HexabitzPlatform/H07R8x/README.md

# H07R8x-Hardware
Hexabitz 10W Stereo Audio Amplifier Module Hardware Design
