HexabitzPlatform/H07R8x/Rleased/BOM/H07R8.xlsx

 |  | www.hexabitz.com info@hexabitz.com |  | Bill Of Materials
Customer | Hexabitz | Revision | 0
Project | Hexabitz Modules | Date | 2024-02-20
Board | 10W Stereo Audio Amplifier (H07R8) | Notes
Designator | Description | Manufacturer Part Number | Manufacturer | Octopart Url | Quantity
R | Headers & Wire Housings Unshrouded 1 POS T/H | 5-146280-1 | TE Connectivity | https://octopart.com/5-146280-1-te+connectivity+%2F+amp-40259676?r=sp | 1
SWD | Conn Unshrouded Header HDR 3 POS 2.54mm Solder ST Top Entry Thru-Hole Carton | 5-146281-3 | TE Connectivity | https://octopart.com/5-146281-3-te+connectivity+%2F+amp-39745942?r=sp | 1
J1, J2, J3 | TERM BLK 2POS SIDE ENT 3.5MM PCB | 1751248 | Phoenix Contact | https://octopart.com/1751248-phoenix+contact-31334?r=sp | 3
J4 | CONN JACK STEREO 3.5MM SMD R/A | SJ-3524-SMT-TR | CUI Devices | https://octopart.com/sj-3524-smt-tr-cui+devices-106234236?r=sp | 1
R1, FB3, FB4, FB5, FB6 | RES SMD 0.0OHM JUMPER 1/10W 0603 | RC0603JR-070RL | YAGEO [VR] | https://octopart.com/rc0603jr-070rl-yageo-1241539?r=sp | 5
R5, R10, R11, R12, R13, R14 | RES 100 OHM 1% 1/10W 0603 | RMCF0603FT100R | YAGEO | https://octopart.com/rmcf0603ft100r-stackpole+electronics-19212927?r=sp | 6
R2 | Thick Film Resistors - SMD 0603 270 Ohm 5% Tol | ERJ-3GEYJ271V | Panasonic | https://octopart.com/erj-3geyj271v-panasonic-55560546?r=sp | 1
R7, R8 | RES 4.7K OHM 1% 1/10W 0603 | RMCF0603FT4K70 | Stackpole Electronics Inc | https://octopart.com/rmcf0603ft4k70-stackpole+electronics-19213269?r=sp | 2
R3, R6, R9 | RES 10K Ohm 1% 0603 | RC0603FR-0710KL | Yageo | https://octopart.com/rc0603fr-0710kl-yageo-40025538?r=sp | 3
R4 | RES 100K OHM 1% 1/10W 0603 | RC0603FR-10100KL | YAGEO | https://octopart.com/rc0603fr-10100kl-yageo-12819539?r=sp | 1
C32, C38, C42, C43 | CAP CER 100PF 50V X7R 0603 | CC0603KPX7R9BB101 | YAGEO | https://octopart.com/cc0603kpx7r9bb101-yageo-25628258?r=sp | 4
C21 | CAP CER 10000PF 50V X7R 0603 | CC0603KRX7R9BB103 | YAGEO | https://octopart.com/cc0603krx7r9bb103-yageo-192938?r=sp | 1
C1, C2, C4, C6, C45 , C8, C9, C13 | CAP CER 0.1UF 25V X7R 0603 | CGA3E2X8R1E104K080AE | TDK | https://octopart.com/cga3e2x8r1e104k080ae-tdk-68305753?r=sp | 8
C10, C11, C18, C19, C20, C22, C23, C24, C25, C27, C28, C39, C40 | CAP CER 0.47UF 25V X5R 0603 | C1608X5R1E474K080AC | TDK Corporation | https://octopart.com/c1608x5r1e474k080ac-tdk-25947645?r=sp | 13
C5 | CAP CER 1 UF 16V X7R 0805 | CC0805KKX7R7BB105 | YAGEO [VA] | https://octopart.com/cc0805kkx7r7bb105-yageo-8376555?r=sp | 1
C15, C16, C17, C33, C34, C35, C36, C37, C44 | CAP CER 1UF 10V X5R 0603 | GRM188R61A105KA61J | MURATA ELECTRON ICS | https://octopart.com/grm188r61a105ka61j-murata-9221870?r=sp | 9
C12 | CAP CER 1UF 50V X5R 0603 | UMK107BJ105KA-T | Taiyo Yuden | https://octopart.com/umk107bj105ka-t-taiyo+yuden-12090744?r=sp | 1
C14 | CAP CER 2.2UF 16V X5R 0603 | CL10A225KO8NNNC | Samsung Electro-Mechanics | https://octopart.com/cl10a225ko8nnnc-samsung-19018971?r=sp | 1
C3 , C7 | CAP CER 4.7UF 16V X7R 0805 | C0805C475K4RACTU | KEMET [VA] | https://octopart.com/c0805c475k4ractu-kemet-22859922?r=sp | 2
C30, C31 | CAP ALUM HYB 47UF 20% 50V SMD | A780EN476M1HLAS050 | KEMET | https://octopart.com/a780en476m1hlas050-kemet-133897287?r=sp | 2
FB1 | Ind chip Bead Multi-Layer 30 ohms 25% 100MHZ Ferrite 1,5A 0603Punched paper T/R | MMZ1608Y300BTA00 | TDK | https://octopart.com/mmz1608y300bta00-tdk-7906990?r=sp | 1
Q2 | MOSFET N-CH 30V 5.7A SOT23-3L | AO3400A | Alpha & Omega Semiconductor Inc. | https://octopart.com/ao3400a-alpha+%26+omega+semiconductor-10533924?r=spc#CadModels | 1
D1 | Red 0603 130° Clear 54 mcd 2 V Surface Mount ChipLED | VLMS1300-GS08 | Vishay | https://octopart.com/vlms1300-gs08-vishay-21709201?r=sp | 1
D2 | TVS DIODE 3,3V 10,9V SOD323 | CDSOD323-T03SC | BOURNS INC | https://octopart.com/cdsod323-t03sc-bourns-10487153?r=sp | 1
U1 | MCU 32-Bit ARM Cortex-M0+ RISC 512kByte Flash 1.7V to 3.6V 48-Pin UFQFPN Tray | STM32G0B1CEU6N | STMicroelectronics | https://octopart.com/stm32g0b1ceu6n-stmicroelectronics-116364672?r=sp | 1
U2 | IC STEREO AUD CODEC LP 32TQFN | MAX9867ETJ+T | Maxim Integrated Products | https://octopart.com/max9867etj%2Bt-analog+devices-124229035?r=sp | 1
U3 | IC SWITCH SPDTX4 450MOHM 16VQFN | TS3A44159RGTR | Texas Instruments | https://octopart.com/ts3a44159rgtr-texas+instruments-5447085?r=spc#CadModels | 1
U5 | IC AMP CLASS D STEREO 16W 32TQFN | MAX9704ETJ+ | Analog Devices Inc./Maxim Integrated | https://octopart.com/max9704etj%2B-analog+devices-40016343?r=sp | 1
U6 | IC REG LIN 1.8V 150MA TSOT23-5 | MIC5365-1.8YD5-TR | Microchip Technology | https://octopart.com/mic5365-1.8yd5-tr-microchip-66803184?r=spc#CadModels | 1
X1 | 8,0000MHZ 33pF SMD MURATA Resonators | CSTNE8M00G550000R0 | Murata | https://octopart.com/cstne8m00g550000r0-murata-91406934?r=sp | 1
