HexabitzPlatform/H07R8x/Documentation/H07R8 Schematics.pdf

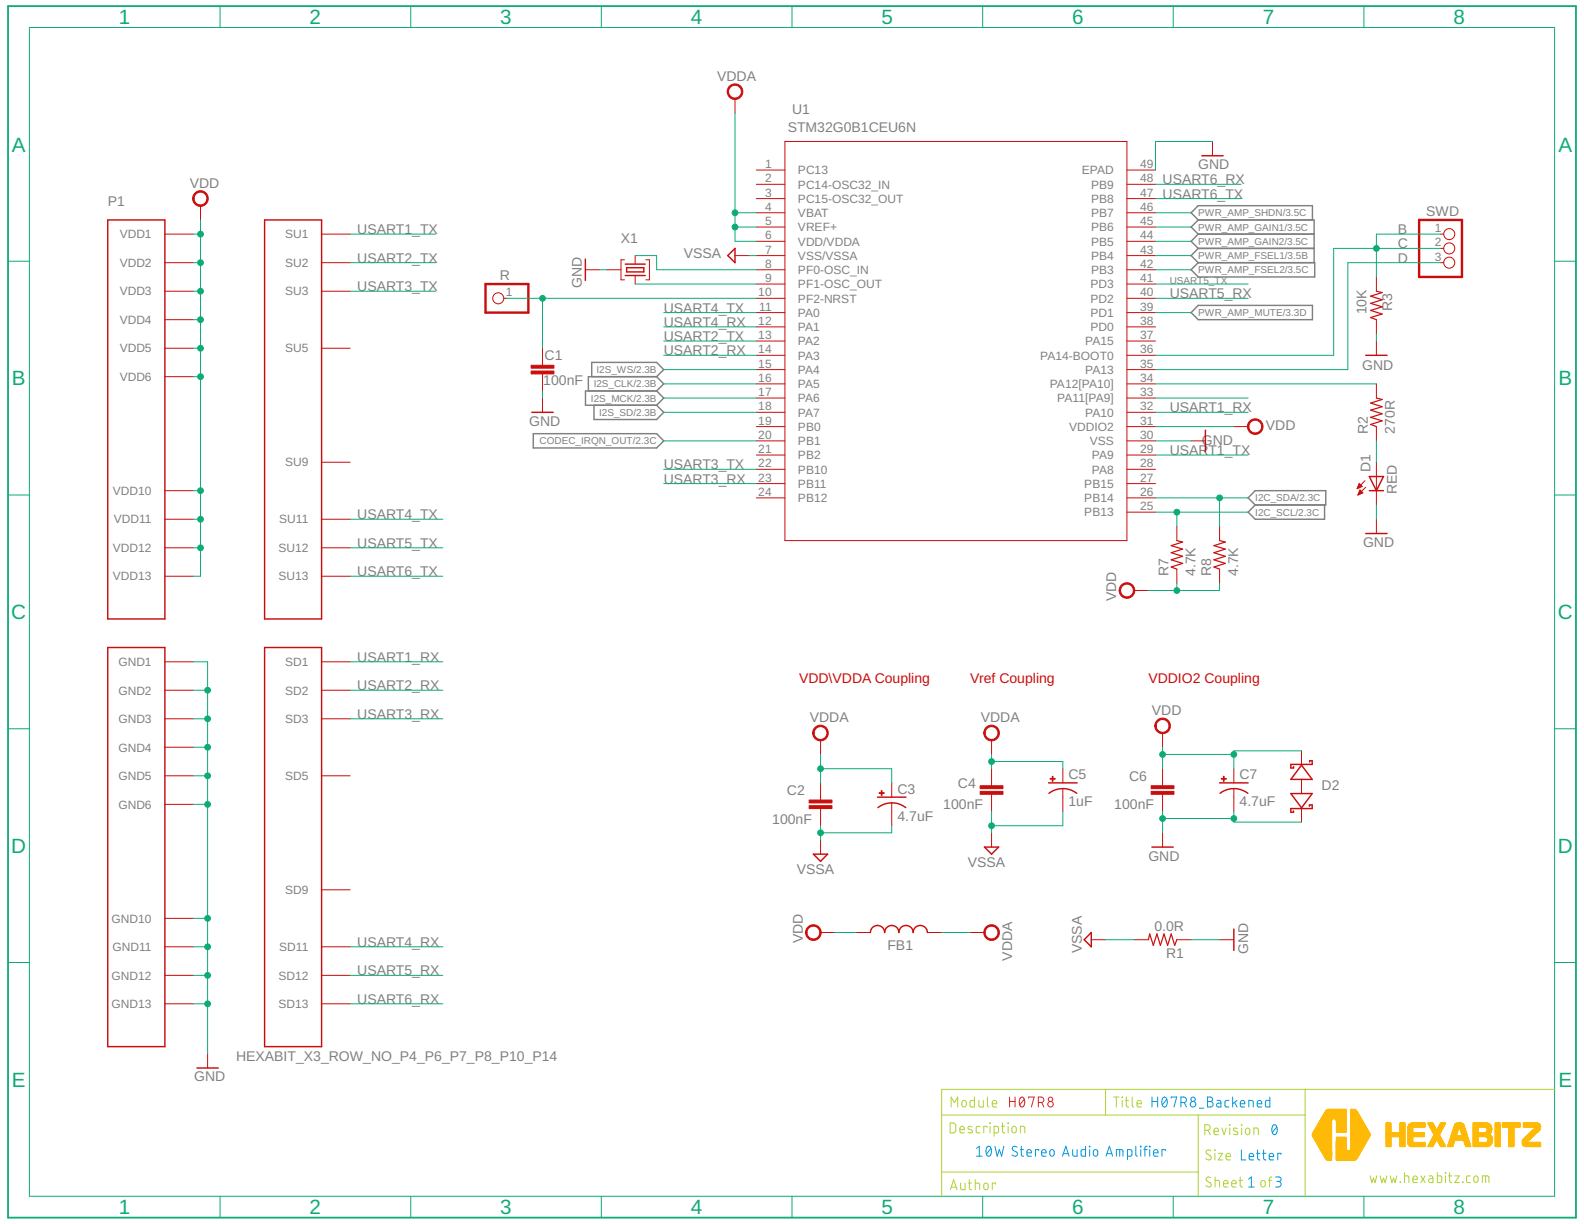
[picture p1: page 1]

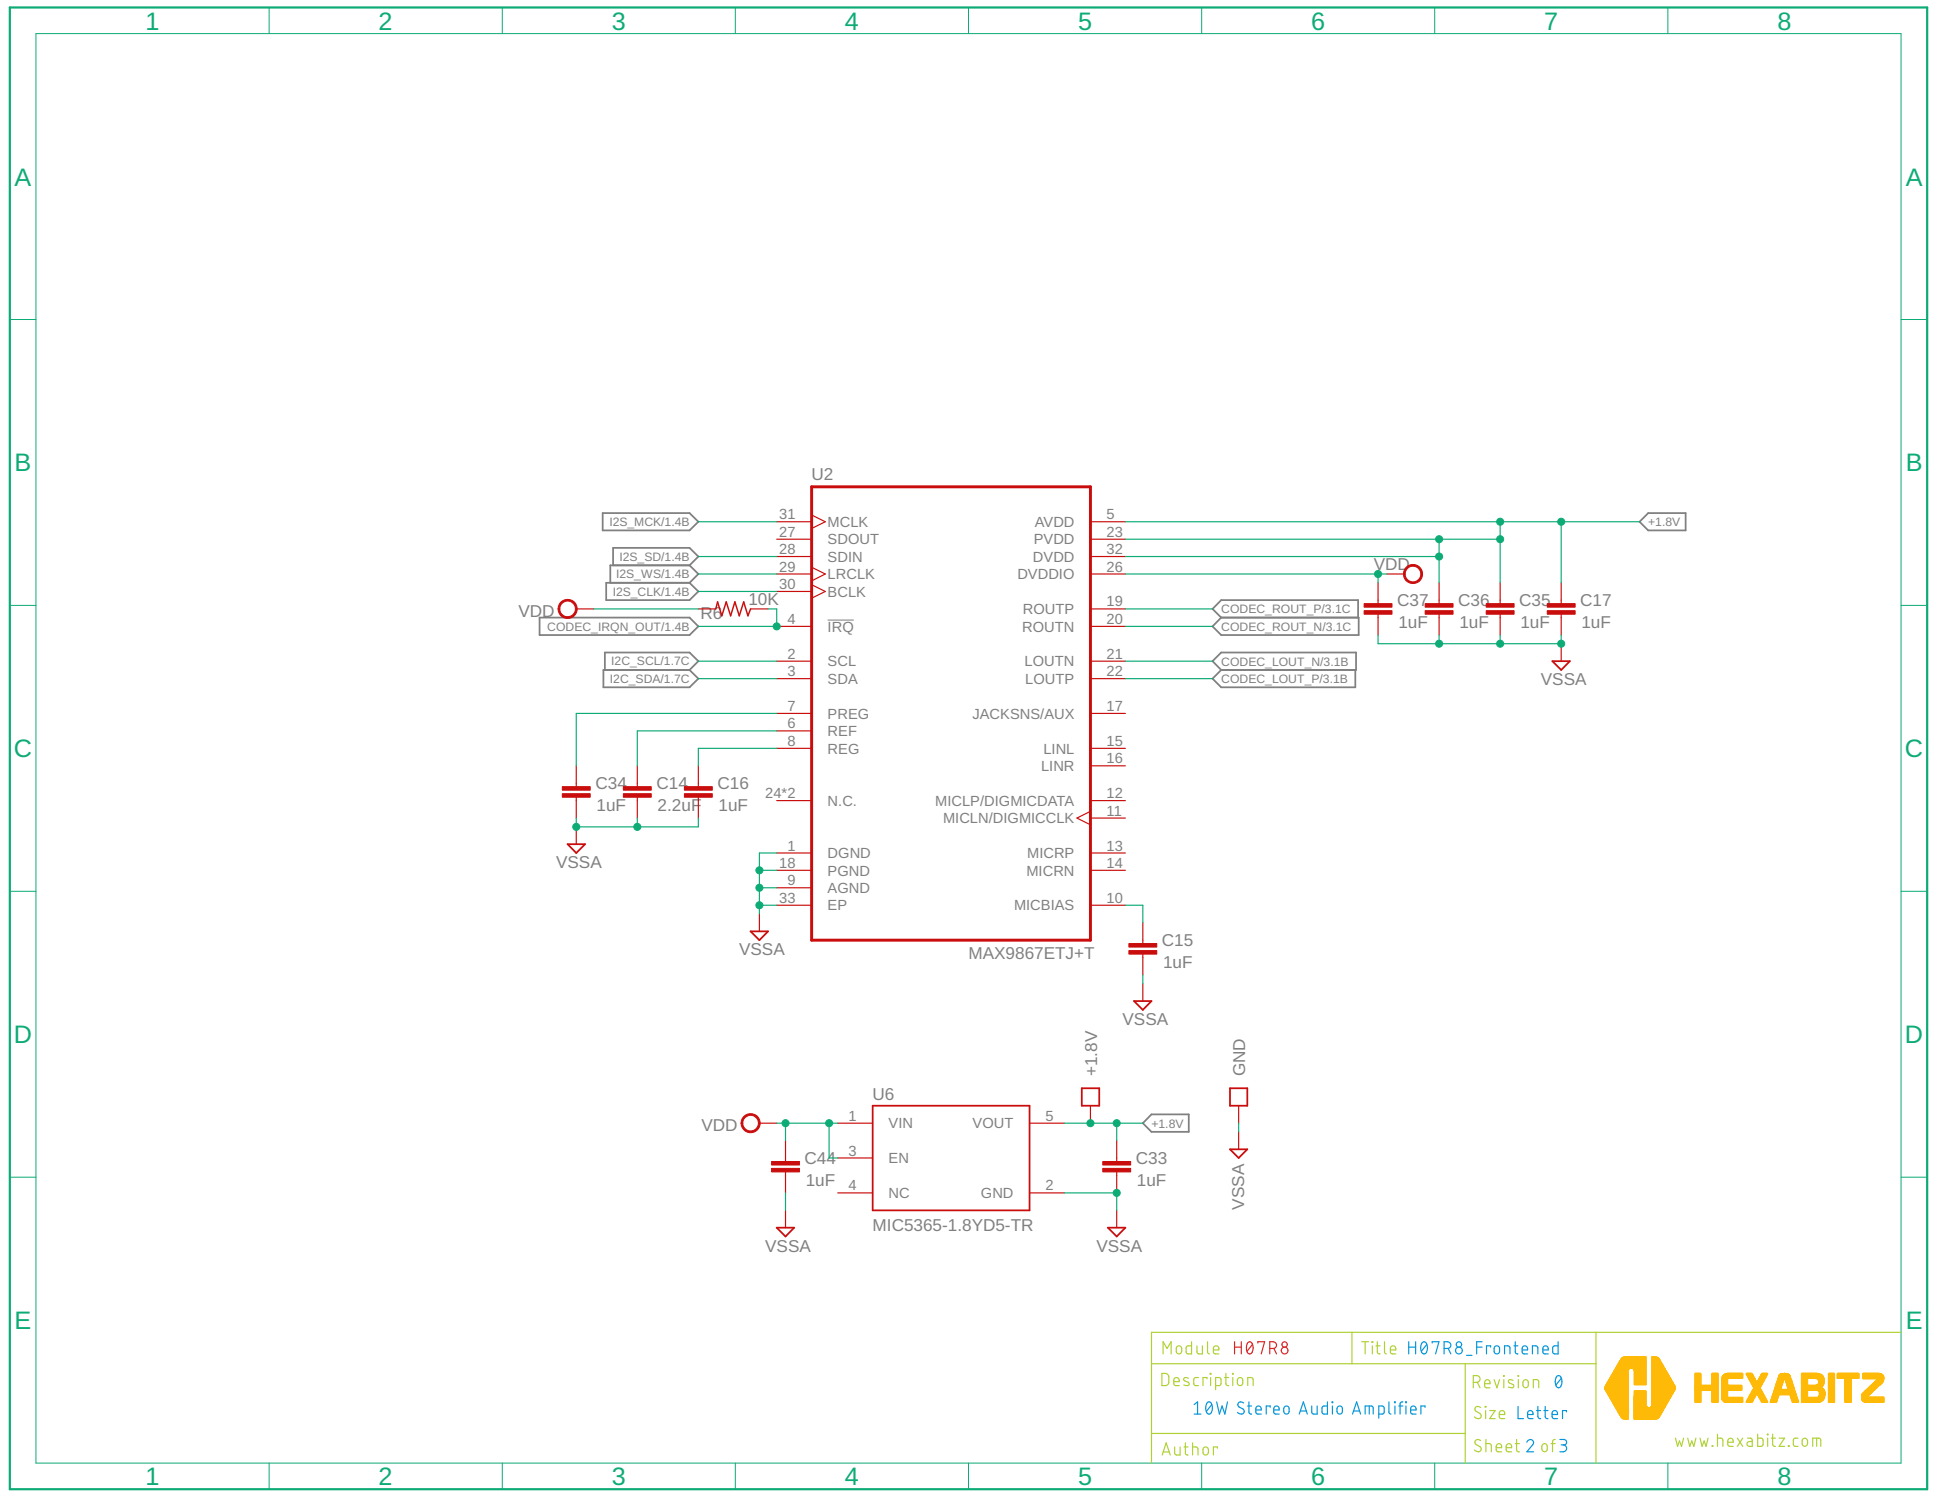
[picture p2: page 2]

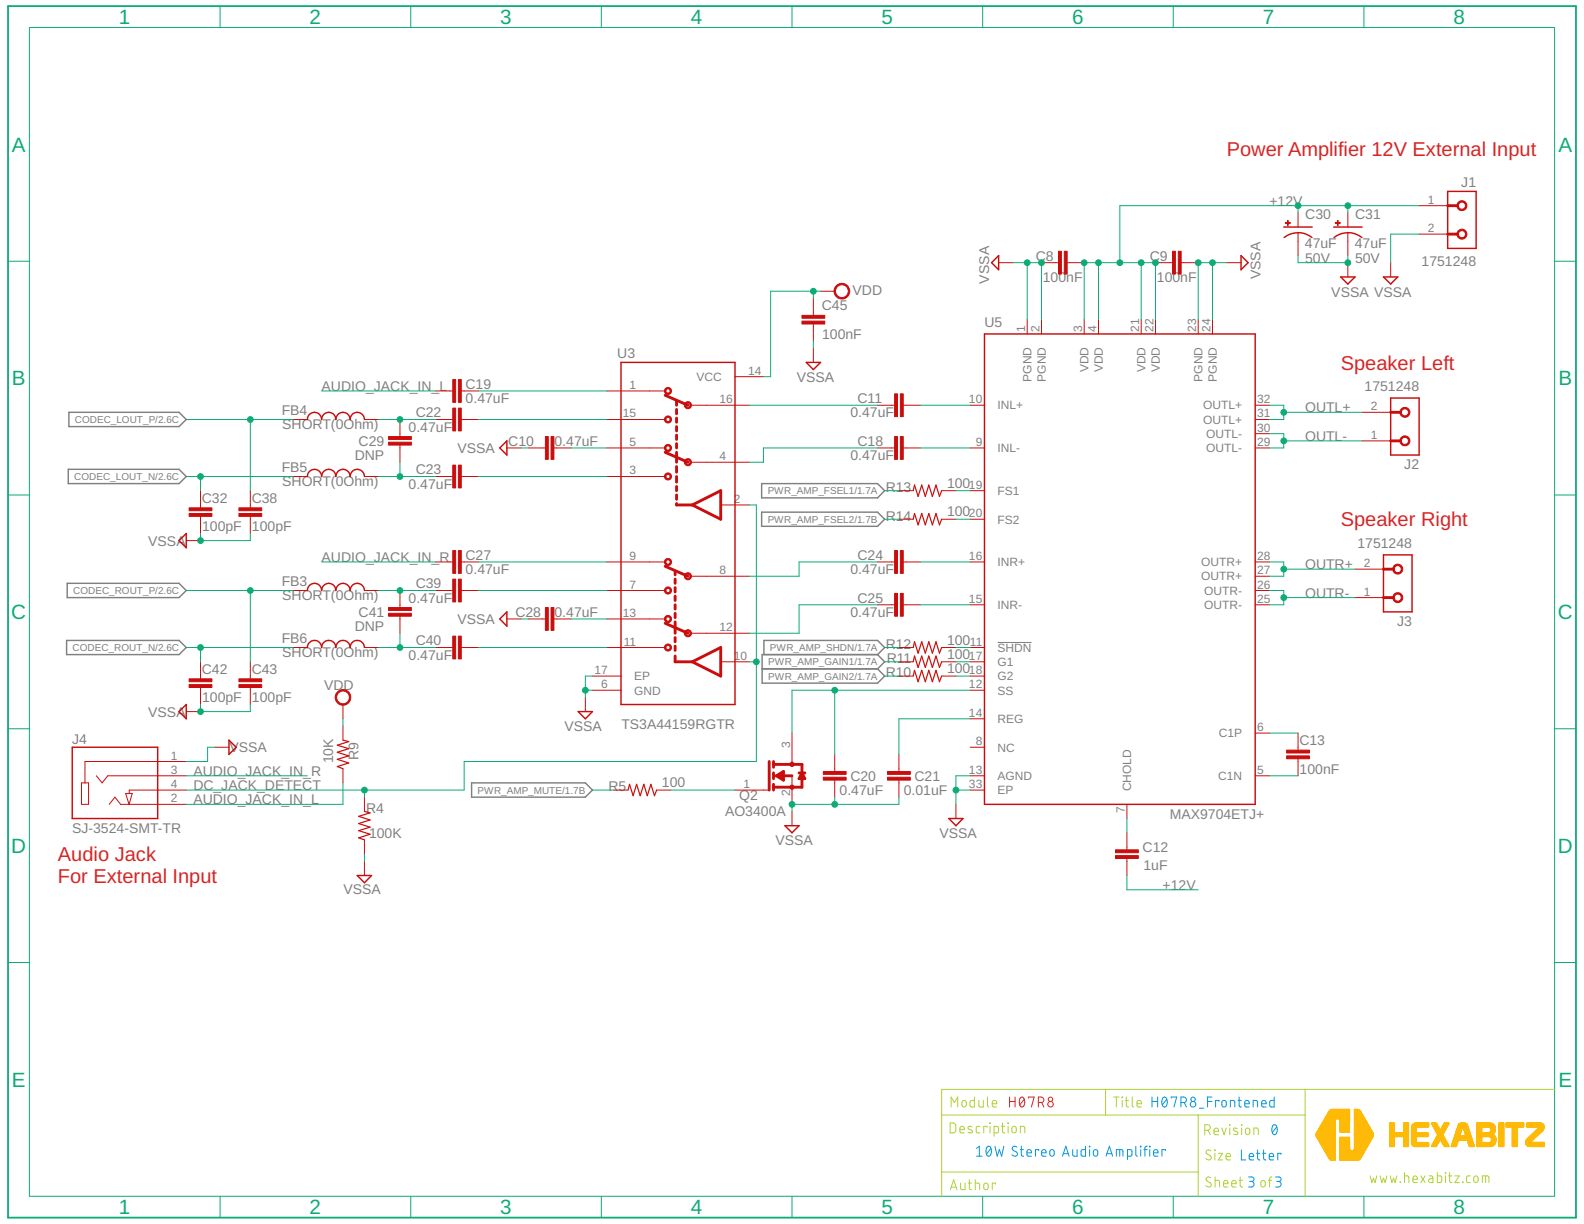
[picture p3: page 3]

Power Amplifier 12V External Input

23 PGND
OUTL+ OUTL- OUTR+ OUTR-
