HexabitzPlatform/H07R8x/Design/H07R8.brd

## EAGLE design Design/H07R8.brd (2024-04-30)

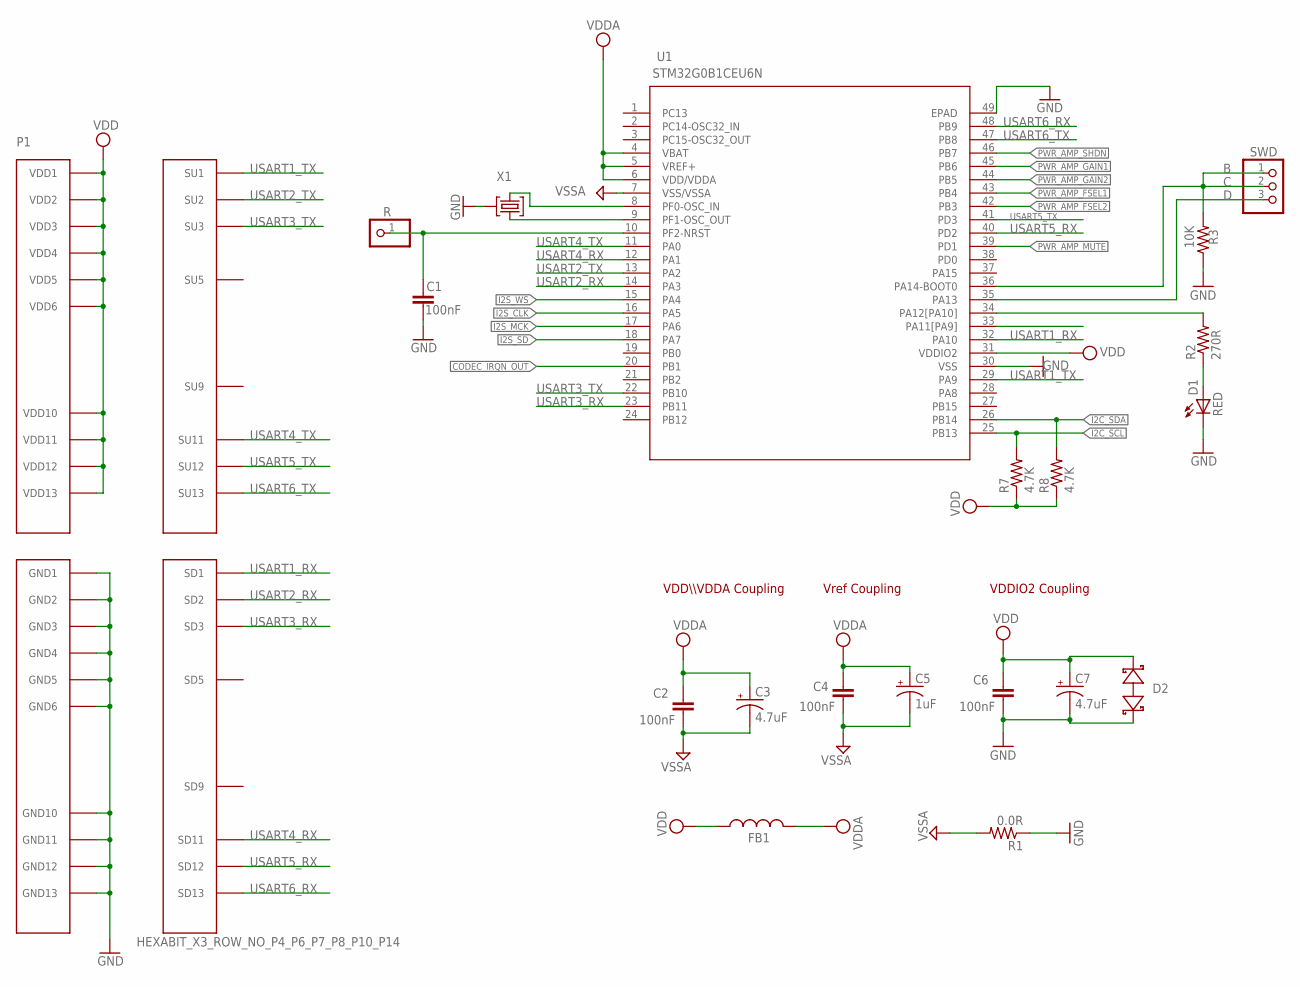
[picture p4: schematic H07R8.sch, sheet 1, I/O parts]

Parts:
C1: 100nF; C-0603; TOLERANCE 10%; VOLTAGE_RATING 16.0 V; MPN 0603YC104K4T2A
C2, C4, C6: 100nF; C-0603; TOLERANCE 10%; VOLTAGE_RATING 16.0 V; MPN '0603YC104K4T2A
C3: 4.7uF; C-0805-POL; TOLERANCE 20%; VOLTAGE_RATING 10.0 V; MPN '10TPU4R7MSI
C5: 1uF; C-0805-POL; TOLERANCE 20%; VOLTAGE_RATING 10.0 V; MPN 'CC0805KKX7R7BB105
C7: 4.7uF; C-0805-POL; TOLERANCE 10%; VOLTAGE_RATING 16.0 V; MPN '10TPU4R7MSI
D1: RED; VLMS1300-GS08
D2: BOURNS_CDSOD323-T03SCBOURNS_CDSOD323-T03SC_0_0; BOURNS_CDSOD323-T03SC_0
FB1: FB-TDK_MMZ1608Y300B; MPN MMZ1608Y300BTA00
P1: HEXABIT_X3_ROW_NO_P4_P6_P7_P8_P10_P14
R: PINHD-1X1; 1X01
R1: 0.0R; R-0603; MPN RC0603JR-070RL
R2: 270R; R-0603; MPN 'ERJ-3GEYJ271V
R3: 10K; R-0603; MPN '060300J0103T5E
R7, R8: 4.7K; R-0603; TOLERANCE ±1%; MPN RMCF0603FT4K70
SWD: PINHD-1X3; 1X03
TRIMBLE-LOGO3: HEXA-LOGO
U1: STM32G0B1CEU6N; HEXABITZ_ICS_QFN_B1CEU6_STM-L
X1: 8MHZ; XTALL_CSTCE8M00G52; MPN CSTNE8M00G550000R0

Connections:
C: R3.2, SWD.1, SWD.2, U1.36 (PA14-BOOT0)
CODEC_IRQN_OUT: U1.20 (PB1); also elsewhere on the board
D: SWD.3, U1.35 (PA13)
GND: C1.1, C6.1, C7.2 (-), D1.C, D2.1 (A), P1.PAD_PD15 (GND1), P1.PAD_PD16 (GND2), P1.PAD_PD17 (GND3), P1.PAD_PD18 (GND4), P1.PAD_PD19 (GND5), P1.PAD_PD24 (GND6), P1.PAD_PD25 (GND10), P1.PAD_PD26 (GND11), P1.PAD_PD27 (GND12), P1.PAD_PD28 (GND13), R1.1, R3.1, U1.30 (VSS), U1.49 (EPAD), X1.P$2 (2)
GND1: C2.1, C3.2 (-), C4.1, C5.2 (-), R1.2, U1.7 (VSS/VSSA); also elsewhere on the board
I2C_SCL: R7.2, U1.25 (PB13); also elsewhere on the board
I2C_SDA: R8.2, U1.26 (PB14); also elsewhere on the board
I2S_CLK: U1.16 (PA5); also elsewhere on the board
I2S_MCK: U1.17 (PA6); also elsewhere on the board
I2S_SD: U1.18 (PA7); also elsewhere on the board
I2S_WS: U1.15 (PA4); also elsewhere on the board
unnamed: U1.8 (PF0-OSC_IN), X1.P$1 (1)
unnamed: U1.9 (PF1-OSC_OUT), X1.P$3 (3)
unnamed: R2.2, U1.34 (PA12[PA10])
unnamed: D1.A, R2.1
unnamed: C1.2, R.1, U1.10 (PF2-NRST)
PWR_AMP_FSEL1: U1.43 (PB4); also elsewhere on the board
PWR_AMP_FSEL2: U1.42 (PB3); also elsewhere on the board
PWR_AMP_GAIN1: U1.45 (PB6); also elsewhere on the board
PWR_AMP_GAIN2: U1.44 (PB5); also elsewhere on the board
PWR_AMP_MUTE: U1.39 (PD1); also elsewhere on the board
PWR_AMP_SHDN: U1.46 (PB7); also elsewhere on the board
USART1_RX: P1.PAD_PD1 (SD1), U1.32 (PA10)
USART1_TX: P1.PAD_PU1 (SU1), U1.29 (PA9)
USART2_RX: P1.PAD_PD2 (SD2), U1.14 (PA3)
USART2_TX: P1.PAD_PU2 (SU2), U1.13 (PA2)
USART3_RX: P1.PAD_PD3 (SD3), U1.23 (PB11)
USART3_TX: P1.PAD_PU3 (SU3), U1.22 (PB10)
USART4_RX: P1.PAD_PD11 (SD11), U1.12 (PA1)
USART4_TX: P1.PAD_PU11 (SU11), U1.11 (PA0)
USART5_RX: P1.PAD_PD12 (SD12), U1.40 (PD2)
USART5_TX: P1.PAD_PU12 (SU12), U1.41 (PD3)
USART6_RX: P1.PAD_PD13 (SD13), U1.48 (PB9)
USART6_TX: P1.PAD_PU13 (SU13), U1.47 (PB8)
VDD: C6.2, C7.1 (+), D2.2 (C), FB1.1, P1.PAD_PU15 (VDD1), P1.PAD_PU16 (VDD2), P1.PAD_PU17 (VDD3), P1.PAD_PU18 (VDD4), P1.PAD_PU19 (VDD5), P1.PAD_PU24 (VDD6), P1.PAD_PU25 (VDD10), P1.PAD_PU26 (VDD11), P1.PAD_PU27 (VDD12), P1.PAD_PU28 (VDD13), R7.1, R8.1, U1.31 (VDDIO2); also elsewhere on the board
VDDA: C2.2, C3.1 (+), C4.2, C5.1 (+), FB1.2, U1.4 (VBAT), U1.5 (VREF+), U1.6 (VDD/VDDA)

Notes on the sheet:
VDDIO2 Coupling
VDD\\\VDDA Coupling
Vref Coupling

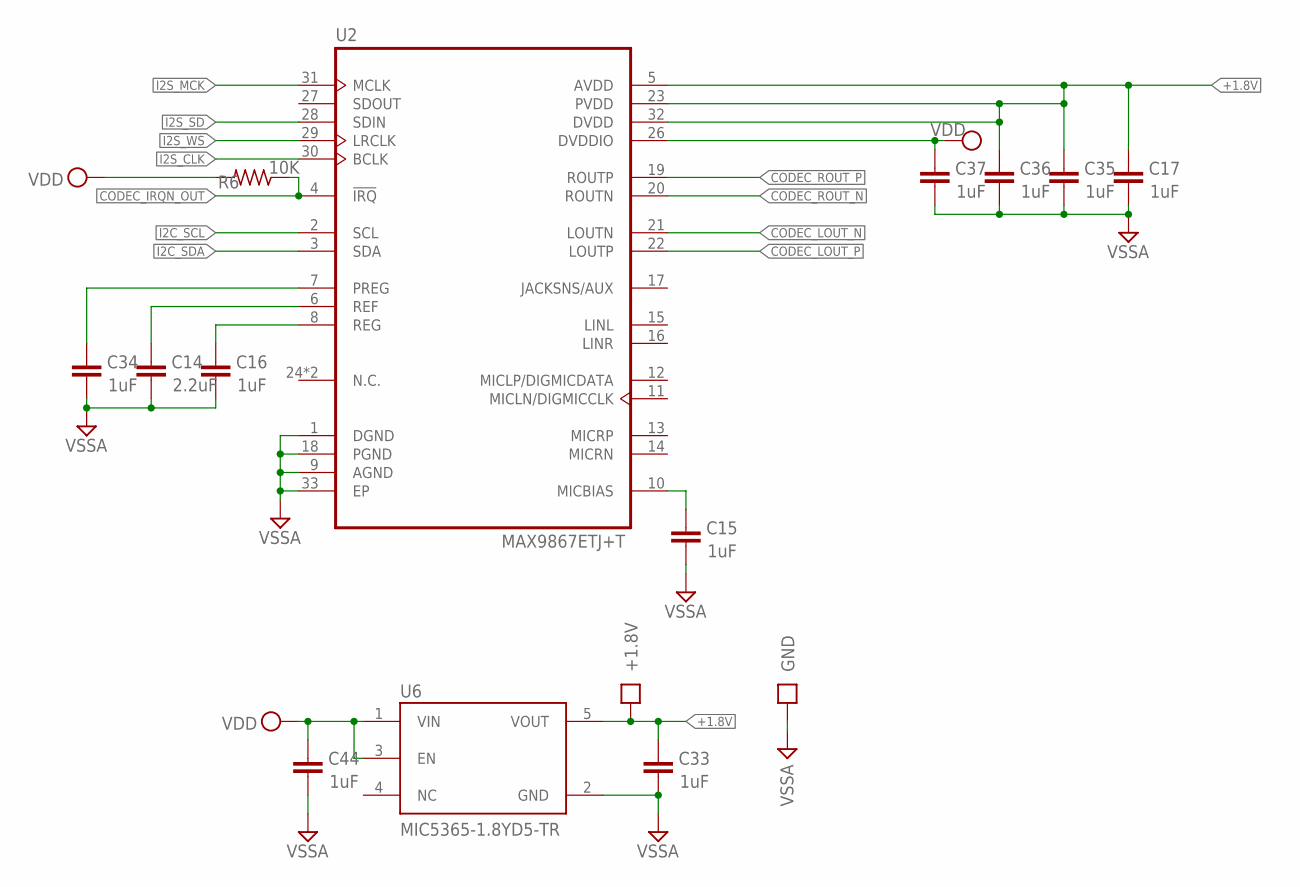
[picture p5: schematic H07R8.sch, sheet 2]

Parts:
+1.8V: PAD4
C14: 2.2uF; C-0603; TOLERANCE 10%; VOLTAGE_RATING 16V; MPN CL10A225KO8NNNC
C15, C16, C17, C33, C34, C35, C36, C37, C44: 1uF; C-0603; TOLERANCE 10%; VOLTAGE_RATING 50V; MPN UMK107BJ105KA-T
GND: PAD4
R6: 10K; R-0603; MPN '060300J0103T5E
U2: MAX9867ETJ+T; QFN50P500X500X80-33N
U6: MIC5365-1.8YD5-TRMICROCHIP_MIC5365-1_8YD5-TR_0_0; MICROCHIP_MIC5365-1_8YD5-TR_0

Connections:
+1.8V: +1.8V.P$1, C17.2, C33.2, C35.2, C36.2, U2.5 (AVDD), U2.23 (PVDD), U2.32 (DVDD), U6.5 (VOUT)
CODEC_IRQN_OUT: R6.1, U2.4 (!IRQ); also elsewhere on the board
CODEC_LOUT_N: U2.21 (LOUTN); also elsewhere on the board
CODEC_LOUT_P: U2.22 (LOUTP); also elsewhere on the board
CODEC_ROUT_N: U2.20 (ROUTN); also elsewhere on the board
CODEC_ROUT_P: U2.19 (ROUTP); also elsewhere on the board
GND1: C14.1, C15.1, C16.1, C17.1, C33.1, C34.1, C35.1, C36.1, C37.1, C44.1, GND.P$1, U2.1 (DGND), U2.9 (AGND), U2.18 (PGND), U2.33 (EP), U6.2 (GND); also elsewhere on the board
I2C_SCL: U2.2 (SCL); also elsewhere on the board
I2C_SDA: U2.3 (SDA); also elsewhere on the board
I2S_CLK: U2.30 (BCLK); also elsewhere on the board
I2S_MCK: U2.31 (MCLK); also elsewhere on the board
I2S_SD: U2.28 (SDIN); also elsewhere on the board
I2S_WS: U2.29 (LRCLK); also elsewhere on the board
unnamed: C16.2, U2.8 (REG)
unnamed: C14.2, U2.6 (REF)
unnamed: C34.2, U2.7 (PREG)
unnamed: C15.2, U2.10 (MICBIAS)
VDD: C37.2, C44.2, R6.2, U2.26 (DVDDIO), U6.1 (VIN), U6.3 (EN); also elsewhere on the board

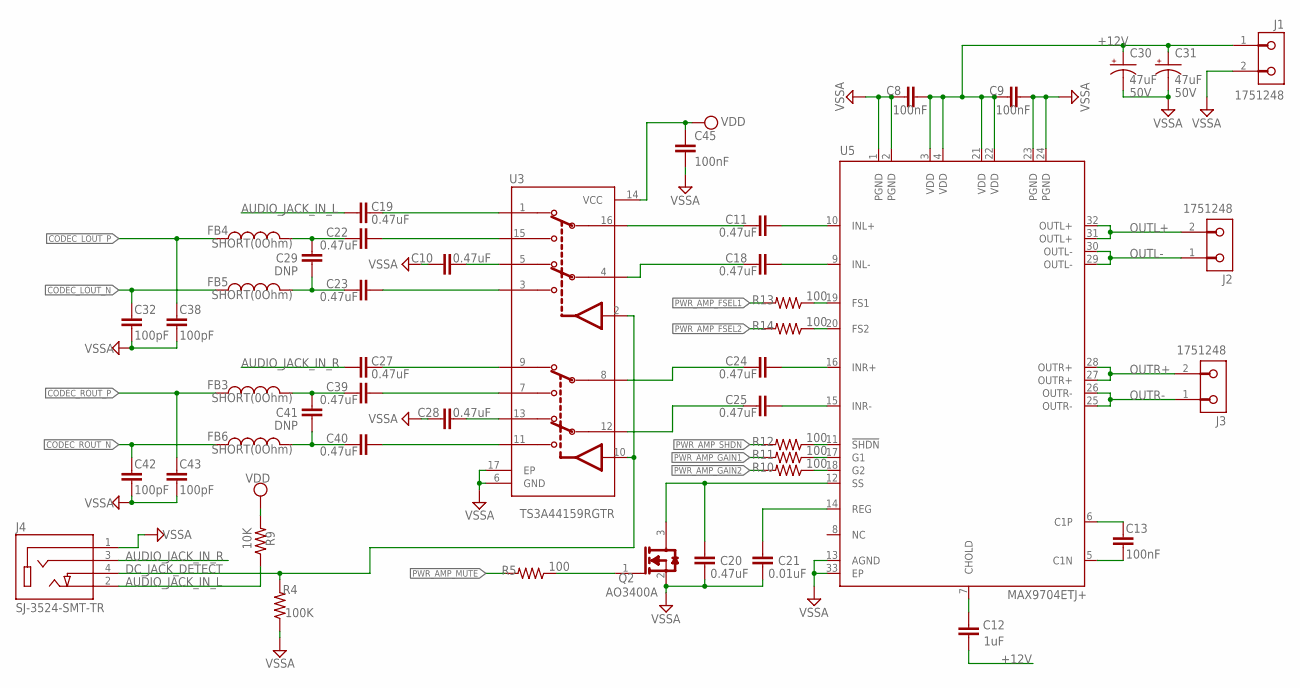
[picture p6: schematic H07R8.sch, sheet 3]

Parts:
C8, C9, C13, C45: 100nF; C-0603; TOLERANCE 10%; VOLTAGE_RATING 25.0 V; MPN CL10B104KA8NNNC
C10, C11, C18, C19, C20, C22, C23, C24, C25, C27, C28, C39, C40: 0.47uF; C-0603; TOLERANCE 10%; VOLTAGE_RATING 25.0 V; MPN C1608X5R1E474K080AC
C12: 1uF; C-0603; TOLERANCE 10%; VOLTAGE_RATING 50V; MPN UMK107BJ105KA-T
C21: 0.01uF; C-0603; TOLERANCE 10%; VOLTAGE_RATING 50.0 V; MPN CC0603KRX7R9BB103
C29, C41: DNP; C-0603
C30, C31: 47uF; PANASONIC_D
C32, C38, C42, C43: 100pF; C-0603; TOLERANCE 10%; VOLTAGE_RATING 50.0 V; MPN CC0603KPX7R9BB101
FB3, FB4, FB5, FB6: SHORT(0Ohm); FB-0603; MPN RC0603FR-070RL
J1, J2, J3: 1751248PHOENIX_CONTACT_1751248_0_0; PHOENIX_CONTACT_1751248_0
J4: SJ-3524-SMT-TR; CUI_SJ-3524-SMT
Q2: AO3400AALPHA_&_OMEGA_SEMICONDUCTOR_AO3400A_0_0; ALPHA_&_OMEGA_SEMICONDUCTOR_AO3400A_0
R4: 100K; R-0603; MPN RC0603FR-10100KL
R5, R10, R11, R12, R13, R14: 100; R-0603; MPN RMCF0603FT100R
R9: 10K; R-0603; MPN '060300J0103T5E
U3: TS3A44159RGTRTEXAS_INSTRUMENTS_TS3A44159RGTR_0_0; TEXAS_INSTRUMENTS_TS3A44159RGTR_0
U5: MAX9704ETJ+; QFN65P700X700X80-33N

Connections:
+12V: C8.1, C9.2, C12.1, C30.+, C31.+, J1.1, U5.3 (VDD), U5.4 (VDD), U5.21 (VDD), U5.22 (VDD)
AUDIO_JACK_IN_L: C19.1, J4.2, R9.1
AUDIO_JACK_IN_R: C27.1, J4.3
CODEC_LOUT_N: C32.2, FB5.1; also elsewhere on the board
CODEC_LOUT_P: C38.2, FB4.1; also elsewhere on the board
CODEC_ROUT_N: C42.2, FB6.1; also elsewhere on the board
CODEC_ROUT_P: C43.2, FB3.1; also elsewhere on the board
DC_JACK_DETECT: J4.4, R4.2, U3.2 (IN1-2), U3.10 (IN3-4)
GND1: C8.2, C9.1, C10.1, C20.2, C21.2, C28.1, C30.-, C31.-, C32.1, C38.1, C42.1, C43.1, C45.2, J1.2, J4.1, Q2.2 (S), R4.1, U3.6 (GND), U3.17 (EP), U5.1 (PGND), U5.2 (PGND), U5.13 (AGND), U5.23 (PGND), U5.24 (PGND), U5.33 (EP); also elsewhere on the board
unnamed: C40.1, C41.1, FB6.2
unnamed: C21.1, U5.14 (REG)
unnamed: C12.2, U5.7 (CHOLD)
unnamed: C22.2, U3.15 (NO1)
unnamed: C23.2, U3.3 (NO2)
unnamed: C13.1, U5.6 (C1P)
unnamed: C39.2, U3.7 (NO3)
unnamed: C40.2, U3.11 (NO4)
unnamed: C19.2, U3.1 (NC1)
unnamed: C13.2, U5.5 (C1N)
unnamed: C27.2, U3.9 (NC3)
unnamed: C22.1, C29.2, FB4.2
unnamed: C23.1, C29.1, FB5.2
unnamed: C39.1, C41.2, FB3.2
unnamed: C10.2, U3.5 (NC2)
unnamed: C28.2, U3.13 (NC4)
unnamed: C11.2, U5.10 (INL+)
unnamed: C11.1, U3.16 (COM1)
unnamed: C18.1, U3.4 (COM2)
unnamed: C24.1, U3.8 (COM3)
unnamed: C25.1, U3.12 (COM4)
unnamed: C18.2, U5.9 (INL-)
unnamed: C24.2, U5.16 (INR+)
unnamed: C20.1, Q2.3 (D), U5.12 (SS)
unnamed: C25.2, U5.15 (INR-)
unnamed: R13.1, U5.19 (FS1)
unnamed: R14.1, U5.20 (FS2)
unnamed: R12.1, U5.11 (!SHDN!)
unnamed: R11.1, U5.17 (G1)
unnamed: R10.1, U5.18 (G2)
unnamed: Q2.1 (G), R5.1
OUTL+: J2.2, U5.31 (OUTL+), U5.32 (OUTL+)
OUTL-: J2.1, U5.29 (OUTL-), U5.30 (OUTL-)
OUTR+: J3.2, U5.27 (OUTR+), U5.28 (OUTR+)
OUTR-: J3.1, U5.25 (OUTR-), U5.26 (OUTR-)
PWR_AMP_FSEL1: R13.2; also elsewhere on the board
PWR_AMP_FSEL2: R14.2; also elsewhere on the board
PWR_AMP_GAIN1: R11.2; also elsewhere on the board
PWR_AMP_GAIN2: R10.2; also elsewhere on the board
PWR_AMP_MUTE: R5.2; also elsewhere on the board
PWR_AMP_SHDN: R12.2; also elsewhere on the board
VDD: C45.1, R9.2, U3.14 (VCC); also elsewhere on the board

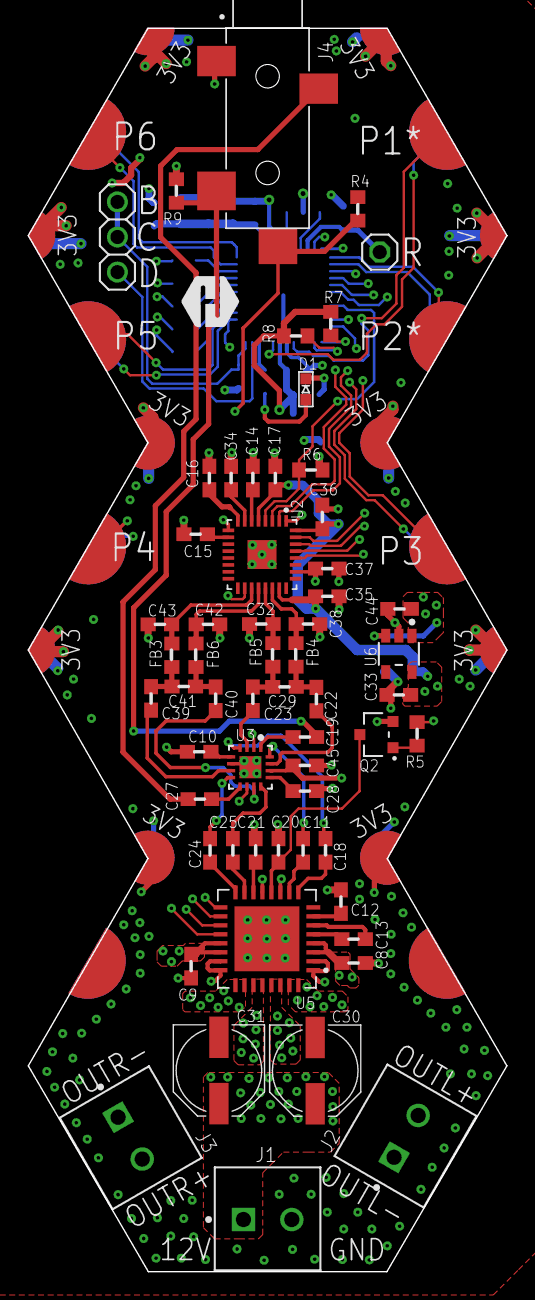
[picture p7: board H07R8.brd from above]

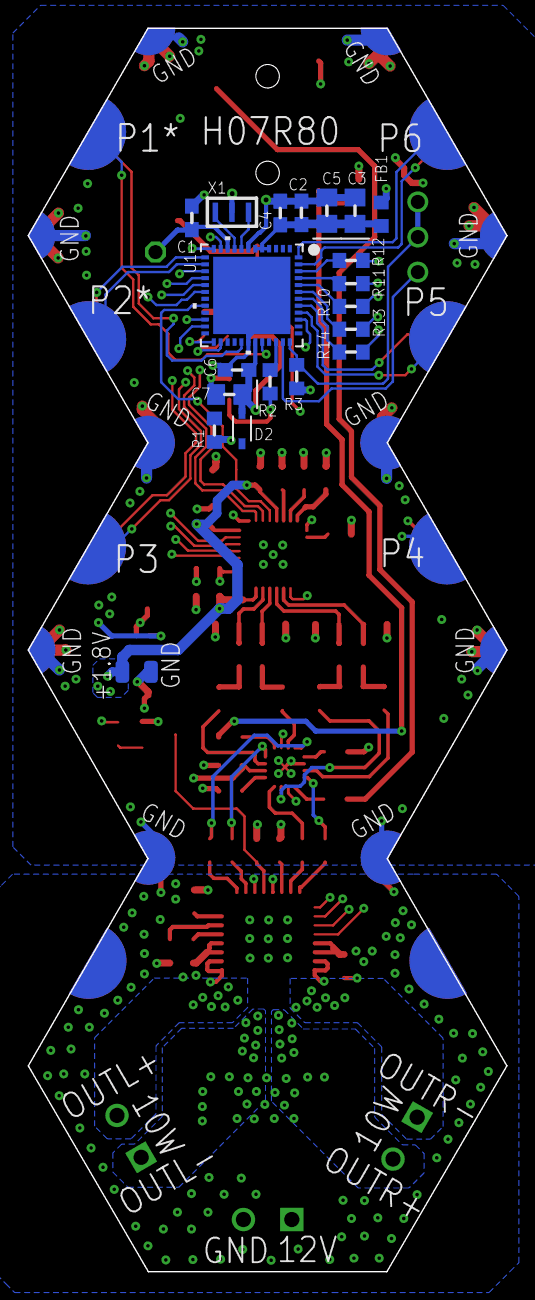
[picture p8: board H07R8.brd from below]

Board: 4 copper layers, 34.6 x 90.0 mm, 82 parts (21 on the bottom side), 84 nets.
