HexabitzPlatform/H07R8x/(commit log)

2023-12-24 -Adding the template files
    [H07R8.brd, H07R8.sch, H07R8.xlsx]
2024-01-01 Creat H07R80 folder
    [H07R8.brd, H07R8.sch, H07R8.xlsx]
2024-02-20 - The reviewed version is complete.
    [H07R8.brd, H07R8.sch, H07R8.xlsx, H07R80 BOM.xlsx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]
2024-02-20 Deleting unnecessary files
    [H07R80 BOM.xlsx]
2024-04-12 Add TVS diode Edit the logo
    [H07R8.brd, H07R8.sch, H07R8.xlsx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]
2024-04-30 -Update BOM
    [H07R8.brd, H07R8.xlsx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]
